murilodepa/Automatic-Cocktail-Shaker-2016/(commit log)

2020-01-24 Microsoft Power Point Presentation
2020-01-24 Video showing the mounting of the project
2020-01-24 Project code used in arduino Mega 2560
